jeandet/USB3_datalogger/gsb343k33hr.stp

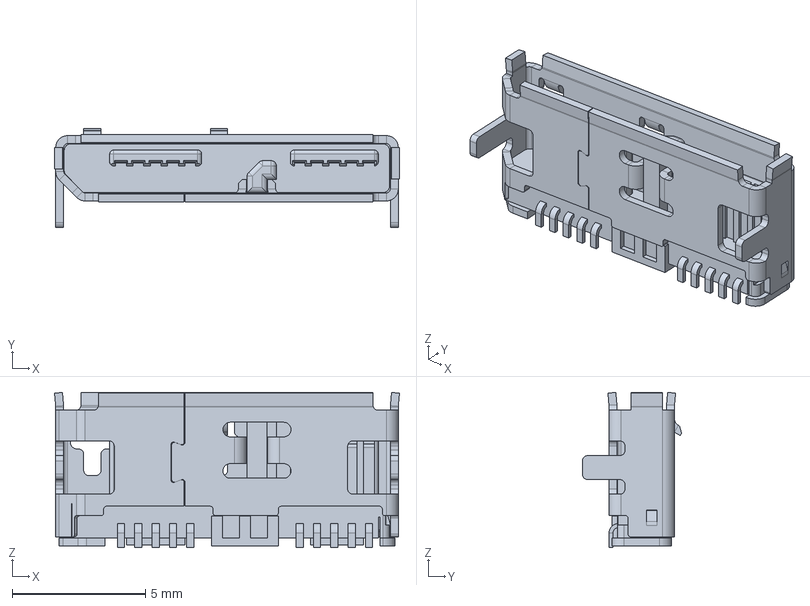
[picture p1: CAD file, 2020-02-18]
gsb343k33hr.stp
12.9 x 3.72 x 5.82 mm
