jeandet/USB3_datalogger/USB3_Datalogger.kicad_pcb

## KiCad design USB3_Datalogger.kicad_pcb (2020-07-23)

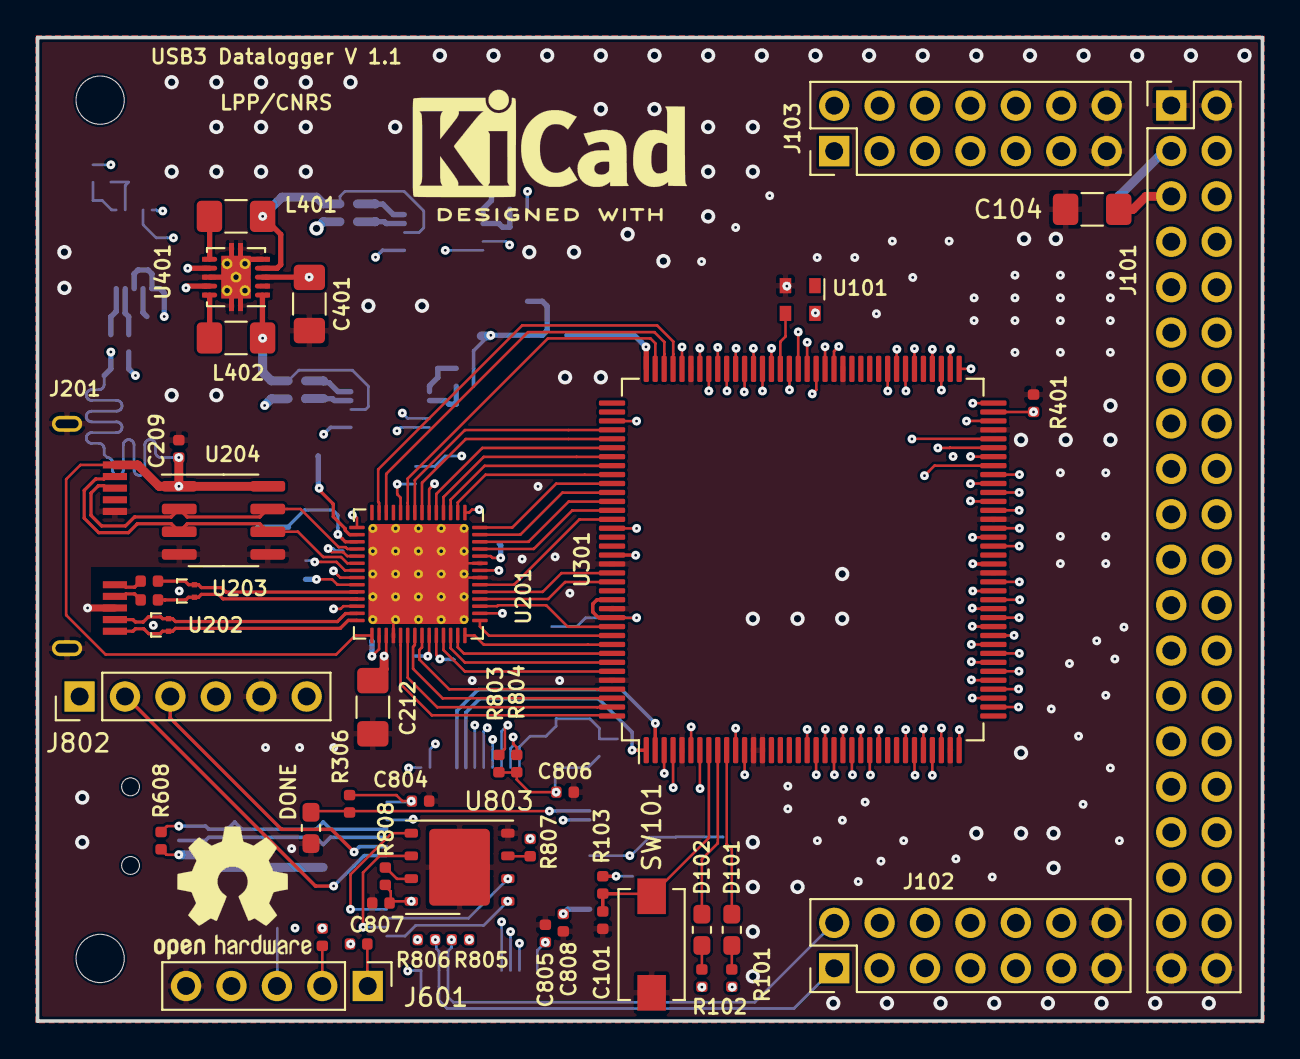
[picture p2: board USB3_Datalogger.kicad_pcb from above]

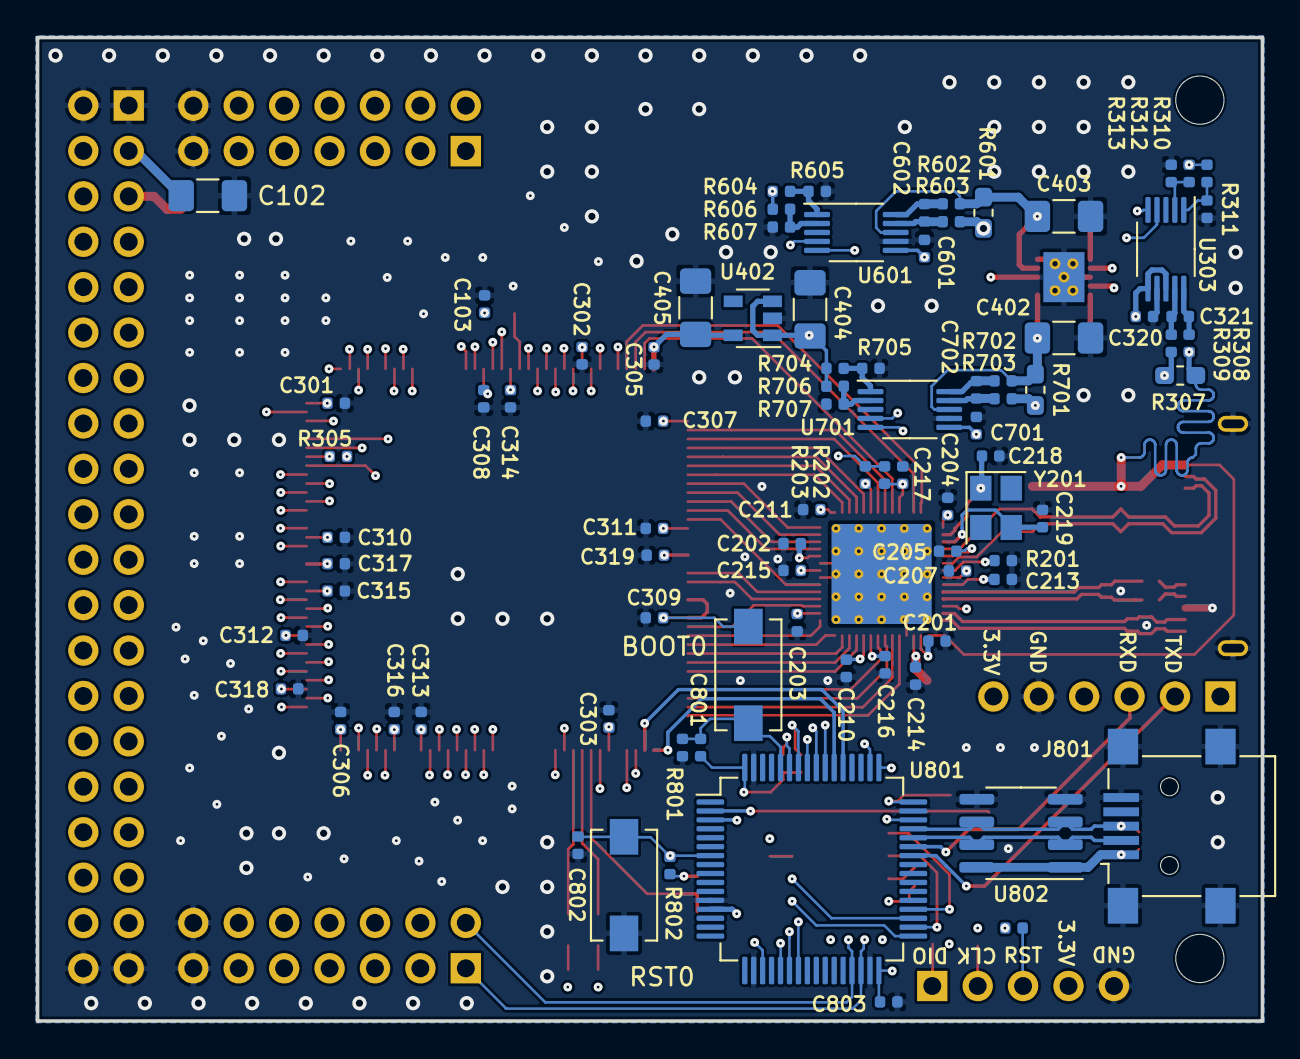
[picture p3: board USB3_Datalogger.kicad_pcb from below]

Board: 6 copper layers, 68.5 x 55.0 mm, 136 parts (86 on the bottom side), 155 nets.

Parts:
BOOT0: SW_Push; SW_SPST_EVQPE1
C101, C103, C201, C202, C203, C204, C205, C206, C207, C208, C209, C210, C211, C213, C214, C215, C216, C217, C301, C302, C303, C305, C306, C307, C308, C309, C310, C311, C312, C313, C314, C315, C316, C317, C318, C319, C320, C601, C701, C801, C802, C803, C804, C805, C806, C807, C808: 100nF; C_0402_1005Metric
C102, C104: 10µF; C_1206_3216Metric_Pad1.42x1.75mm_HandSolder
C212: 4.7µF; C_1206_3216Metric_Pad1.42x1.75mm_HandSolder
C218, C219: 18pF; C_0402_1005Metric
C321, C602, C702: 10pF; C_0402_1005Metric
C401, C402, C403, C404, C405: 10uF; C_1206_3216Metric_Pad1.42x1.75mm_HandSolder
D101, D102: LED; R_0603_1608Metric_Pad1.05x0.95mm_HandSolder
DONE401: LED; R_0603_1608Metric_Pad1.05x0.95mm_HandSolder
H101, H102: MountingHole; MountingHole_2.7mm_M2.5
J101: Conn_02x20_Odd_Even; PinHeader_2x20_P2.54mm_Vertical
J102, J103: Conn_02x07_Odd_Even; PinHeader_2x07_P2.54mm_Vertical
J201: USB3-micro; GSB343K33HR
J601: Conn_01x05; PinHeader_1x05_P2.54mm_Vertical
J801: USB_B_Mini; USB_Mini-B_Lumberg_2486_01_Horizontal
J802: Conn_01x06; PinHeader_1x06_P2.54mm_Vertical
L401, L402: 2.2uH; L_1206_3216Metric_Pad1.42x1.75mm_HandSolder
LOGO101: Logo_Open_Hardware_Small; OSHW-Logo2_9.8x8mm_SilkScreen
LOGO102: Logo_Open_Hardware_Small; KiCad-Logo2_6mm_SilkScreen
R101, R102, R103, R306, R801, R802, R803, R804, R805, R806: 2K2; R_0402_1005Metric
R201: 1.6k; R_0402_1005Metric
R202, R203, R305, R310, R311, R312, R313, R401, R604, R605, R606, R607, R704, R705, R706, R707, R807, R808: 10k; R_0402_1005Metric
R307, R601, R701: 100m; C_0603_1608Metric_Pad1.05x0.95mm_HandSolder
R308, R309, R602, R603, R702, R703: 10; R_0402_1005Metric
R608: 4k7; R_0402_1005Metric
R609, R610, R611: 22; R_0402_1005Metric
RST0: SW_Push; SW_SPST_EVQPE1
SW101: SW_Push; SW_SPST_EVQPE1
U101: ASDMB-xxxMHz; Oscillator_SMD_Abracon_ASDMB-4Pin_2.5x2.0mm
U201: FT600; QFN-56-1EP_7x7mm_P0.4mm_EP5.6x5.6mm_ThermalVias
U202, U203: TPD2EUSB30; Texas_DRT-3
U204, U802: USB6B1; SOIC-8_3.9x4.9mm_P1.27mm
U301: ICE40HX1K-4K-TQ144; TQFP-144_20x20mm_P0.5mm
U303, U601, U701: INA226; VSSOP-10_3x3mm_P0.5mm
U401: tps6240x; Texas_S-PVSON-N10_ThermalVias
U402: TLV73325PDBV; SOT-23-5
U801: STM32F103RCTx; LQFP-64_10x10mm_P0.5mm
U803: W25Q32JVZP; WSON-8-1EP_6x5mm_P1.27mm_EP3.4x4.3mm
Y201: 30MHz; Crystal_SMD_3225-4Pin_3.2x2.5mm

Connections:
/2.5V: C305.1, C405.1, U301.108, U402.5
/Ext_I2C_SCL: J102.2, R805.2, U801.29
/Ext_I2C_SDA: J102.1, R806.2, U801.30
/FPGA/DATA_0: U201.33, U301.144
/FPGA/DATA_1: U201.34, U301.143
/FPGA/DATA_2: U201.35, U301.142
/FPGA/DATA_3: U201.36, U301.141
/FPGA/DATA_4: U201.39, U301.139
/FPGA/DATA_5: U201.40, U301.138
/FPGA/DATA_6: U201.41, U301.137
/FPGA/DATA_7: U201.42, U301.136
/FPGA/DATA_8: U201.45, U301.134
/FPGA/DATA_9: U201.46, U301.129
/FPGA/DATA_10: U201.47, U301.128
/FPGA/DATA_11: U201.48, U301.122
/FPGA/DATA_12: U201.53, U301.121
/FPGA/DATA_13: U201.54, U301.120
/FPGA/DATA_14: U201.55, U301.119
/FPGA/DATA_15: U201.56, U301.118
/FPGA/FIFO_GPIO_0: U201.12, U301.106
/FPGA/FIFO_GPIO_1: U201.13, U301.105
/FPGA/FLASH_CDONE: DONE401.2, R306.2, U301.65, U801.2
/FPGA/FLASH_CLK: U301.70, U801.55
/FPGA/FLASH_MISO: U301.67, U801.56
/FPGA/FLASH_MOSI: U301.68, U801.57
/FPGA/FLASH_SS: R401.1, U301.71, U801.50
/FPGA/FLASH_~CRESET: R305.2, U301.66, U801.3
/FPGA/~FIFO_OE: U201.9, U301.107
/FPGA/~FIFO_RD: U201.8, U301.112
/FPGA/~FIFO_RXF: U201.5, U301.114
/FPGA/~FIFO_TXE: U201.4, U301.115
/FPGA/~FIFO_WR: U201.7, U301.113
/IOB_1: J101.33, U301.38
/IOB_2: J101.34, U301.39
/IOB_3: J101.31, U301.41
/IOB_4: J101.32, U301.42
/IOB_5: J101.29, U301.43
/IOB_6: J101.30, U301.44
/IOB_7: J101.27, U301.45
/IOB_8: J101.28, U301.47
/IOB_9: J101.25, U301.48
/IOB_10: J101.26, U301.49
/IOB_11: J101.23, U301.50
/IOB_12: J101.24, U301.52
/IOB_13: J101.21, U301.56
/IOB_14: J101.22, U301.58
/IOB_15: J101.19, U301.60
/IOB_16: J101.20, U301.61
/IOB_17: J101.17, U301.62
/IOB_18: J101.18, U301.63
/IOB_19: J101.15, U301.64
/IOL_0: U301.1, U801.54
/IOL_1: U301.2, U801.53
/IOL_2: U301.3, U801.23
/IOL_3: U301.4, U801.22
/IOL_4: U301.7, U801.21
/IOL_5: C101.1, R103.2, SW101.2, U301.8
/IOL_6: D102.1, U301.9
/IOL_7: D101.1, U301.10
/IOL_8: J102.3, U301.11
/IOL_9: J102.4, U301.12
/IOL_10: J102.5, U301.19
/IOL_11: J102.6, U301.20
/IOL_12: J102.7, U301.21
/IOL_13: J102.8, U301.22
/IOL_14: J102.9, U301.23
/IOL_15: J102.10, U301.24
/IOL_16: J102.11, U301.25
/IOL_17: J102.12, U301.26
/IOL_20: J101.37, U301.31
/IOL_21: J101.38, U301.32
/IOL_22: J101.35, U301.33
/IOL_23: J101.36, U301.34
/IOR_0: J101.16, U301.73
/IOR_1: J101.13, U301.74
/IOR_2: J101.14, U301.75
/IOR_3: J101.11, U301.76
/IOR_4: J101.12, U301.78
/IOR_5: J101.9, U301.79
/IOR_6: J101.10, U301.80
/IOR_7: J101.7, U301.81
/IOR_8: J101.8, U301.87
/IOR_9: J103.11, U301.88
/IOR_10: J103.12, U301.90
/IOR_11: J103.9, U301.91
/IOR_12: U101.3, U301.93
/IOR_13: J103.10, U301.94
/IOR_14: J103.7, U301.95
/IOR_15: J103.8, U301.96
/IOR_16: J103.5, U301.97
/IOR_17: J103.6, U301.98
/IOR_18: J103.3, U301.99
/IOR_19: J103.4, U301.101
/IOR_20: J103.1, U301.102
/IOR_21: J103.2, U301.104
/Power/1V2Monitor/A0: R606.2, R607.1, U601.2
/Power/1V2Monitor/A1: R604.2, R605.1, U601.1
/Power/3V3Monitor/A0: R706.2, R707.1, U701.2
/Power/3V3Monitor/A1: R704.2, R705.1, U701.1
/Power/#1.2V: C403.1, L401.2, R601.1, R602.2, U401.4, U601.8
/Power/#3.3V: C402.1, L402.2, R701.1, R702.2, U401.1, U701.8
/STM32/BOOT0: BOOT0.2, C801.2, R801.1, U801.60
/STM32/FLASH_CLK: U801.34, U803.6
/STM32/FLASH_MISO: U801.35, U803.2
/STM32/FLASH_MOSI: U801.36, U803.5
/STM32/FLASH_~CS: U801.33, U803.1
/STM32/FLASH_~HOLD: R808.2, U803.7
/STM32/FLASH_~WP: R807.2, U803.3
/STM32/Int_SCL: R803.2, U303.5, U601.5, U701.5, U801.58
/STM32/Int_SDA: R804.2, U303.4, U601.4, U701.4, U801.59
/STM32/RESET: C802.1, R611.2, R802.2, RST0.1, U801.7
/STM32/SWCLK: R610.2, U801.49
/STM32/SWDIO: R609.2, U801.46
/STM32/UART1_RX: J802.3, U801.43
/STM32/UART1_TX: J802.2, U801.42
/STM32/USB_D+: J801.3, R608.2, U801.45, U802.3, U802.6
/STM32/USB_D-: J801.2, U801.44, U802.2, U802.7
/STM32/VBUS: J801.1, R608.1, U802.1, U802.8
/USB3/5VUSBMON/A0: R312.2, R313.1, U303.2
/USB3/5VUSBMON/A1: R310.2, R311.1, U303.1
/USB3/BE_0: U201.2, U301.117
/USB3/BE_1: U201.3, U301.116
/USB3/CLK: U201.43, U301.135
/USB3/SSRX+: J201.10, U201.28, U202.1
/USB3/SSRX-: J201.9, U201.27, U202.2
/USB3/SSTX+: C206.2, J201.7
/USB3/SSTX-: C208.2, J201.6
/USB3/TOD+: C206.1, U201.25, U203.1
/USB3/TOD-: C208.1, U201.24, U203.2
/USB3/USB2_D+: J201.3, U201.18, U204.2, U204.7
/USB3/USB2_D-: J201.2, U201.20, U204.3, U204.6
/USB3/VBUS: C209.1, C320.1, J201.1, R307.1, R308.2, R310.1, R312.1, U201.29, U204.1, U204.8, U303.6, U303.8
/USB3/VD10: C211.1, C212.1, C213.1, C214.1, C215.1, C216.1, U201.1, U201.23, U201.26, U201.31, U201.37, U201.50
/USB_5V: C102.1, C401.1, C404.1, C601.1, C701.1, J101.3, J101.4, R307.2, R309.2, R604.1, R606.1, R704.1, R706.1, U401.3, U401.7, U401.9, U402.1, U402.3, U601.6, U701.6
GND: C101.2, C102.2, C103.2, C104.2, C201.2, C202.2, C203.2, C204.2, C205.2, C207.2, C209.2, C210.2, C211.2, C212.2, C213.2, C214.2, C215.2, C216.2, C217.2, C218.1, C219.1, C301.2, C302.2, C303.2, C305.2, C306.2, C307.2, C308.2, C309.2, C310.2, C311.2, C312.2, C313.2, C314.2, C315.2, C316.2, C317.2, C318.2, C319.2, C320.2, C401.2, C402.2, C403.2, C404.2, C405.2, C601.2, C701.2, C802.2, C803.2, C804.2, C805.2, C806.2, C807.2, C808.2, DONE401.1, J101.1, J101.2, J101.39, J101.40, J102.13, J102.14, J103.13, J103.14, J201.5, J201.8, J201.11, J601.5, J801.5, J801.6, J802.5, R201.1, R311.2, R313.2, R401.2, R605.2, R607.2, R705.2, R707.2, R801.2, RST0.2, SW101.1, U101.2, U201.32, U201.49, U201.51, U201.57, U202.3, U203.3, U204.4, U204.5, U301.5, U301.13, U301.14, U301.35, U301.53, U301.59, U301.69, U301.86, U301.103, U301.127, U301.132, U301.140, U303.7, U401.2, U401.5, U401.8, U401.11, U402.2, U601.7, U701.7, U801.12, U801.18, U801.31, U801.47, U801.63, U802.4, U802.5, U803.4, U803.9
unnamed: C217.1, R202.2, U201.10
unnamed: C218.2, U201.16, Y201.1
unnamed: C219.2, U201.17, Y201.3
unnamed: C321.1, R308.1, U303.10
unnamed: C321.2, R309.1, U303.9
unnamed: C602.1, R602.1, U601.10
unnamed: C602.2, R603.1, U601.9
unnamed: C702.1, R702.1, U701.10
unnamed: C702.2, R703.1, U701.9
unnamed: D101.2, R101.2
unnamed: D102.2, R102.2
unnamed: J601.1, R609.1
unnamed: J601.2, R610.1
unnamed: J601.3, R611.1
unnamed: L401.1, U401.6
unnamed: L402.1, U401.10
unnamed: R201.2, U201.21
unnamed: R203.2, U201.6
VCC: C306.1, C307.1, C313.1, C314.1, C315.1, C317.1, C318.1, C319.1, R601.2, R603.2, U301.27, U301.36, U301.40, U301.51, U301.54, U301.92, U301.111, U301.126
VCCIO_0: BOOT0.1, C103.1, C104.1, C201.1, C202.1, C203.1, C204.1, C205.1, C207.1, C210.1, C301.1, C302.1, C303.1, C308.1, C309.1, C310.1, C311.1, C312.1, C316.1, C801.1, C803.1, C804.1, C805.1, C806.1, C807.1, C808.1, J101.5, J101.6, J601.4, J802.6, R101.1, R102.1, R103.1, R202.1, R203.1, R305.1, R306.1, R701.2, R703.2, R802.1, R803.1, R804.1, R805.1, R806.1, R807.1, R808.1, U101.4, U201.15, U201.19, U201.22, U201.30, U201.38, U201.44, U201.52, U301.6, U301.30, U301.46, U301.57, U301.72, U301.89, U301.100, U301.123, U301.131, U301.133, U801.13, U801.19, U801.32, U801.48, U801.64, U803.8
