jeandet/USB3_datalogger/(commit log)

2020-02-17 First init, USB3 layout + FPGA done
    [FPGA.sch, USB3.sch, USB3_Datalogger.kicad_pcb, USB3_Datalogger.sch]
2020-02-18 PCB complete, ready for review.
    [FPGA.sch, USB3.sch, USB3_Datalogger.kicad_pcb, USB3_Datalogger.sch, gsb343k33hr.stp, power.sch]
2020-02-18 Added Oscillator for the FPGA and updated PCB to match Eurocircuits rules.
    [USB3_Datalogger.kicad_pcb, USB3_Datalogger.sch]
2020-02-19 Made the board compatible with HX4K variant
    [FPGA.sch, USB3_Datalogger.kicad_pcb]
2020-02-24 Added STM32F1 as FPGA companion
    [FPGA.sch, STM32.sch, USB3.sch, USB3_Datalogger.kicad_pcb, USB3_Datalogger.sch, power.sch]
2020-02-24 STM32 connected VDDA to 3.3V
    [FPGA.sch, STM32.sch, USB3_Datalogger.kicad_pcb]
2020-02-24 Added many GND vias
    [USB3_Datalogger.kicad_pcb]
2020-03-04 Last cleanups before PCB manufacturing
    [FPGA.sch, INA226.sch, USB3.sch, USB3_Datalogger.kicad_pcb, USB3_Datalogger.sch, power.sch]
2020-07-22 Many fixes for 1.1
    - fixed FTDI power supply mistake(3.3V was floating)
    - updated resistors footprints
    - updated push button footprints
    - connected STM32 UART 1 to programming header
    - added pull up resistor on USB D+ for STM32
    - added 10uF capacitors on 5V and 3.3V near daughter board connectors
    [FPGA.sch, INA226.sch, STM32.sch, USB3.sch, USB3_Datalogger.kicad_pcb, USB3_Datalogger.sch, power.sch]
2020-07-22 Added SWD header to flash and debug STM32 chip
    [STM32.sch, USB3_Datalogger.kicad_pcb]
2020-07-23 Moved FPGA signals to inner layers, many other fixes
    [STM32.sch, USB3_Datalogger.kicad_pcb]
