jeandet/USB3_datalogger/(notices)

Notices in the files:
INA226.sch:
CC-BY-SA
